MikolajDIY/ZEUS_v1.0/photos/part_of_schematic.png

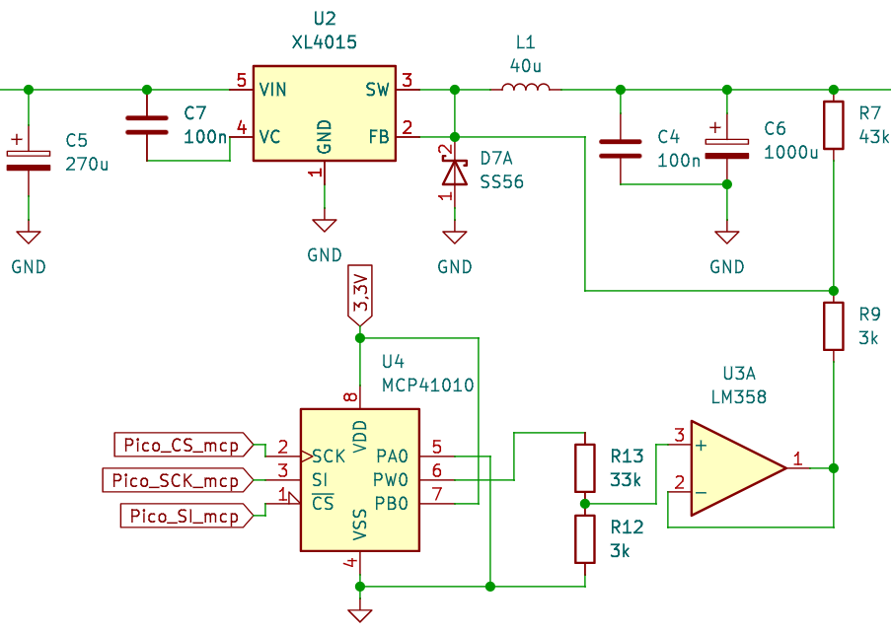
photos/part_of_schematic.png
