MikolajDIY/ZEUS_v1.0/(commit log)

2025-09-23 Update README.md
    DIY digital lab power supply (2.2–18.5 V / 3.5 A) based on Raspberry Pi Pico, MCP41010 and TFT ST7735.
    Features: thermal and current protection, polynomial calibration, custom PCB and enclosure.
2025-09-23 Update and rename ZEUS_kalibracja.csv to ZEUS_calibration.csv
    [ZEUS_calibration.csv]
